ProFiloAutomation/FARMI_PROFI_CH27_Arduino/Schema_Base_Connettori_Fili_Interfaccia_v1.png

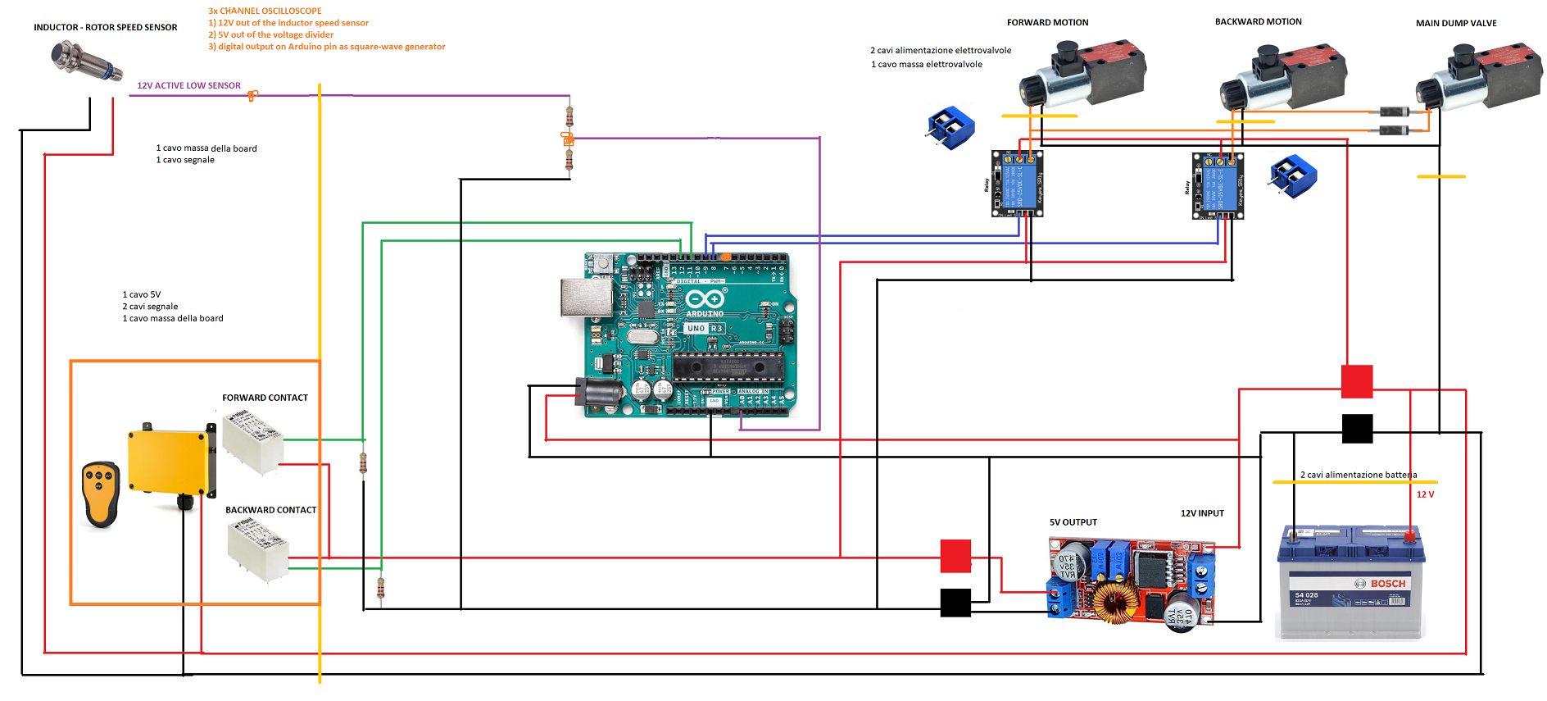
Schema_Base_Connettori_Fili_Interfaccia_v1.png
